DeltaVetal26/ElevatorModel-2.0/PCB/FloorBoard/FloorBoard_Brd.png

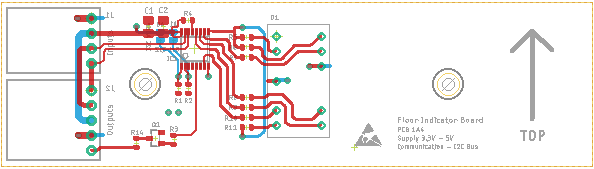
PCB/FloorBoard/FloorBoard_Brd.png
