DeltaVetal26/ElevatorModel-2.0/PCB/FloorBoard/FloorBoard_Sch.png

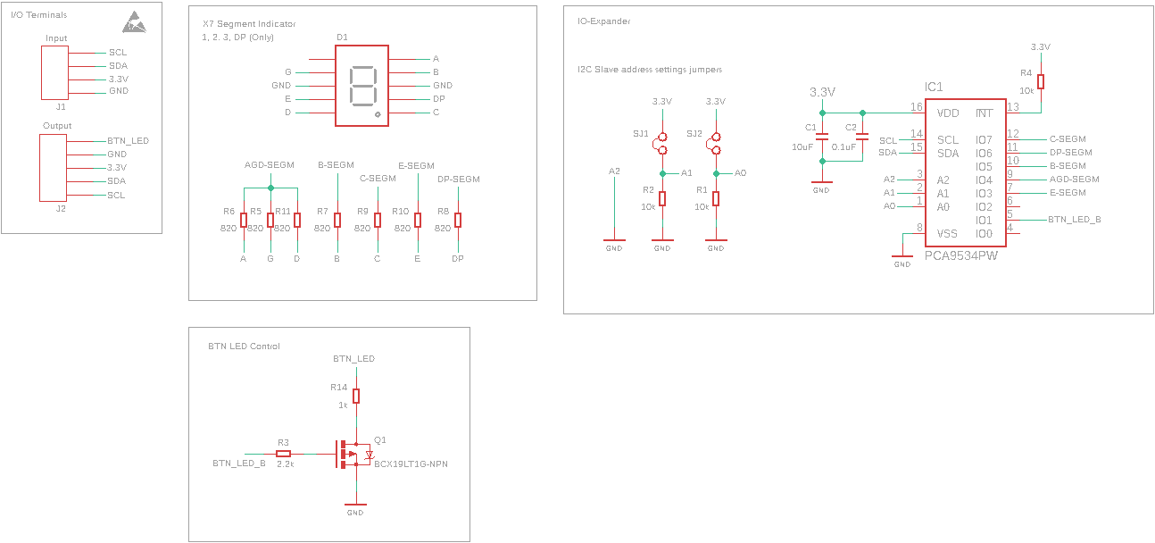
PCB/FloorBoard/FloorBoard_Sch.png
