DeltaVetal26/ElevatorModel-2.0/PCB/FloorBoard/FloorBoard_Vis.png

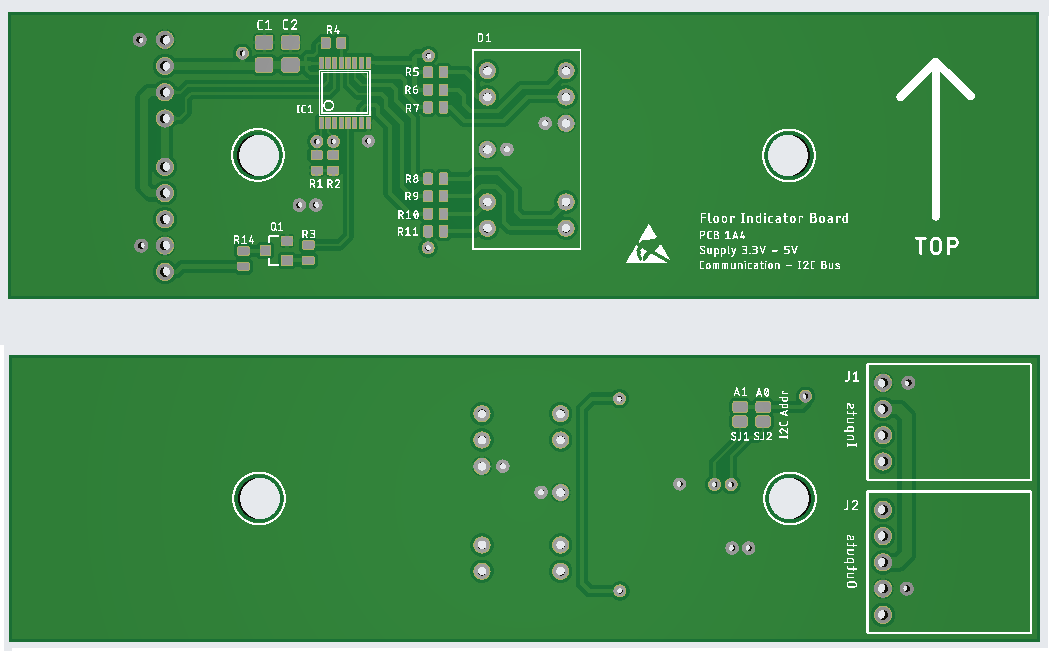
PCB/FloorBoard/FloorBoard_Vis.png
