DeltaVetal26/ElevatorModel-2.0/PCB/MainBoard/MainBoard_Brd.png

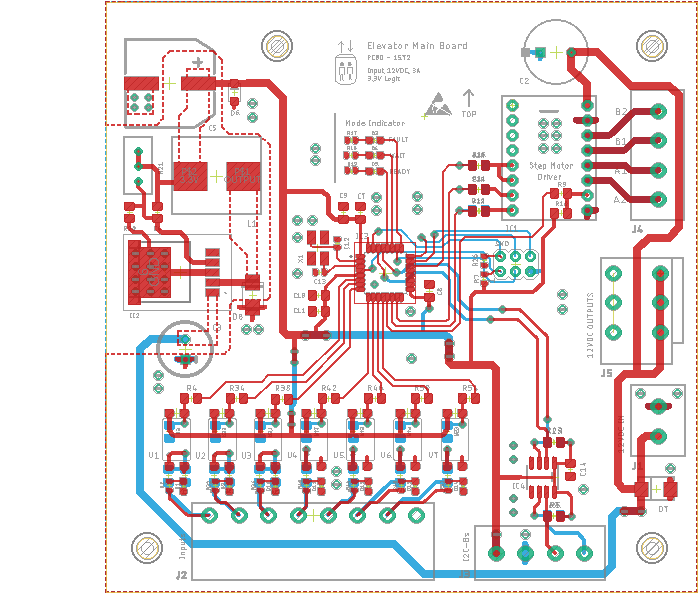
PCB/MainBoard/MainBoard_Brd.png
