DeltaVetal26/ElevatorModel-2.0/PCB/MainBoard/MainBoard_Sch.png

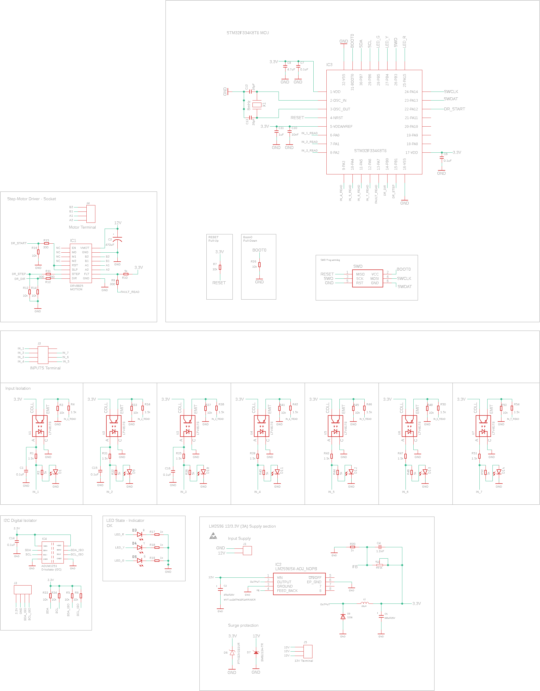
PCB/MainBoard/MainBoard_Sch.png
