DeltaVetal26/ElevatorModel-2.0/PCB/MainBoard/MainBoard_Vis.png

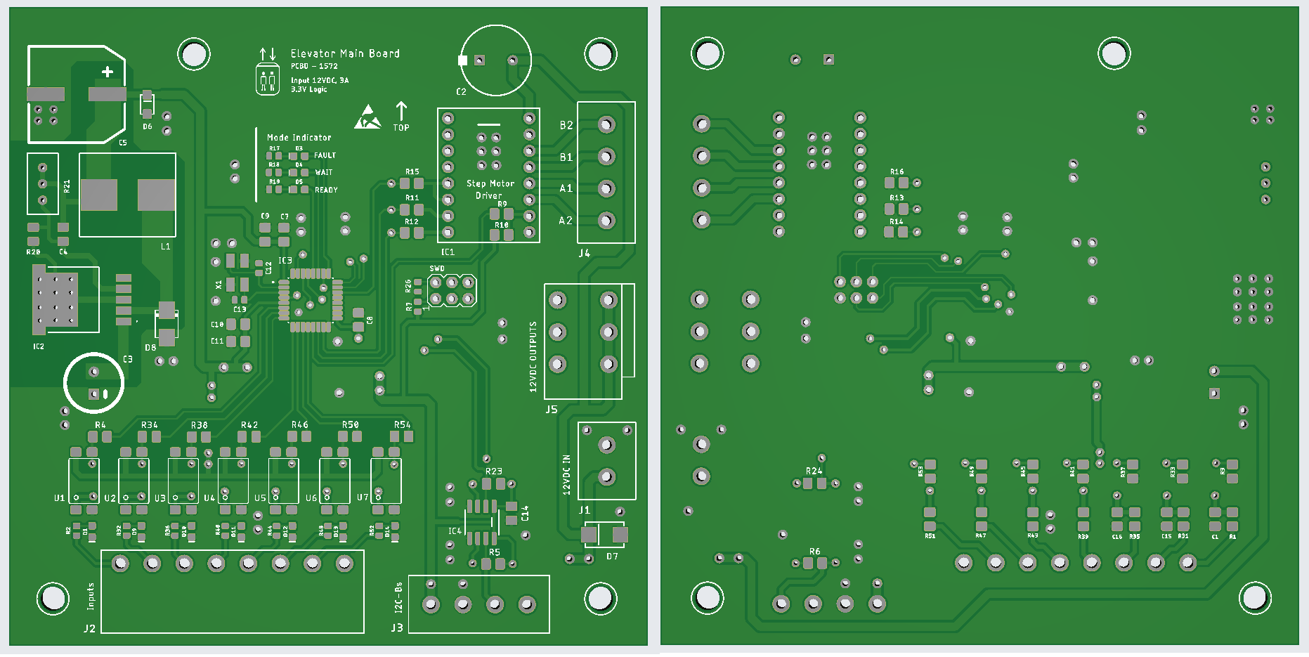
PCB/MainBoard/MainBoard_Vis.png
