DeltaVetal26/ElevatorModel-2.0/PCB/FloorBoard/Schematic.brd

## EAGLE design PCB/FloorBoard/Schematic.brd (2021-07-06)

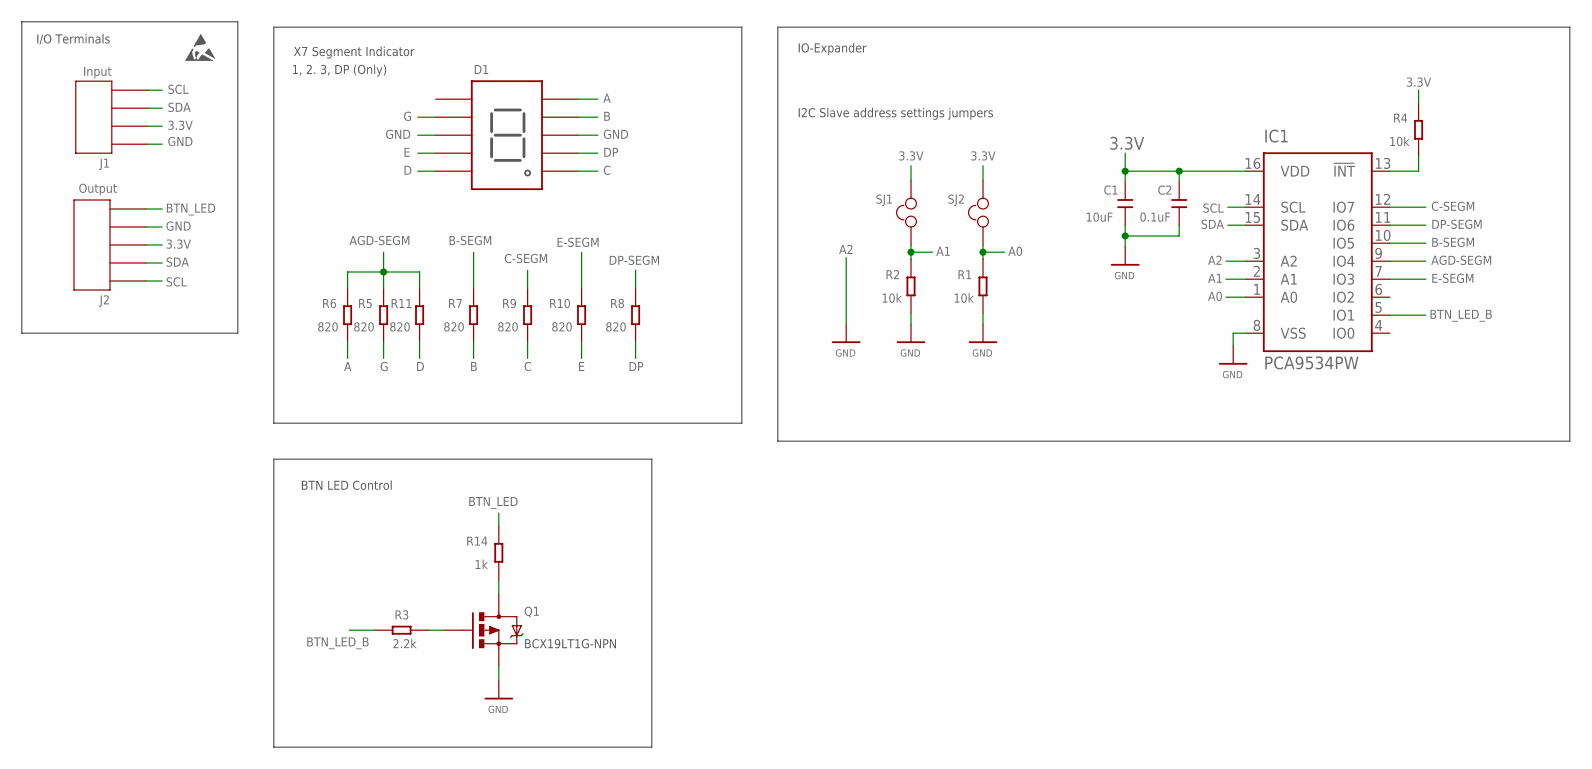
[picture p11: schematic Schematic.sch]

Parts:
C1: 10uF; SMD-CAP-0805
C2: 0.1uF; SMD-CAP-0805
D1: GNS-3011CS-21
IC1: PCA9534PW; TSSOP16
J1: Input; WF-4R
J2: Output; WF-5R
Q1: MOSFET-PCHANNEL; SOT23-3
R1, R2, R4: 10k; SMD-RES-0603
R3: 2.2k; SMD-RES-0603
R5, R6, R7, R8, R9, R10, R11: 820; SMD-RES-0603
R14: 1k; SMD-RES-0603
SJ1, SJ2: SOLDER-JUMPER
U$2: ESD-LOGO

Connections:
3.3V: C1.2, C2.2, IC1.16 (VDD), J1.P$2, J2.P$3, R4.2, SJ1.P$2, SJ2.P$2
A: D1.A, R6.1
A0: IC1.1 (A0), R1.2, SJ2.P$1
A1: IC1.2 (A1), R2.2, SJ1.P$1
A2: IC1.3 (A2)
AGD-SEGM: IC1.9 (IO4), R5.2, R6.2, R11.2
B: D1.B, R7.1
B-SEGM: IC1.10 (IO5), R7.2
BTN_LED: J2.P$5, R14.2
BTN_LED_B: IC1.5 (IO1), R3.2
C: D1.C, R9.1
C-SEGM: IC1.12 (IO7), R9.2
D: D1.D, R11.1
DP: D1.DP, R8.1
DP-SEGM: IC1.11 (IO6), R8.2
E: D1.E, R10.1
E-SEGM: IC1.7 (IO3), R10.2
G: D1.G, R5.1
GND: C1.1, C2.1, D1.CATHODE_1, D1.CATHODE_2, IC1.8 (VSS), J1.P$1, J2.P$4, Q1.2 (S), R1.1, R2.1
unnamed: IC1.13 (!INT), R4.1
unnamed: Q1.3 (D), R14.1
unnamed: Q1.1 (G), R3.1
SCL: IC1.14 (SCL), J1.P$4, J2.P$1
SDA: IC1.15 (SDA), J1.P$3, J2.P$2

Notes on the sheet:
I/O Terminals
X7 Segment Indicator
1, 2. 3, DP (Only)
IO-Expander
I2C Slave address settings jumpers
BCX19LT1G-NPN
BTN LED Control

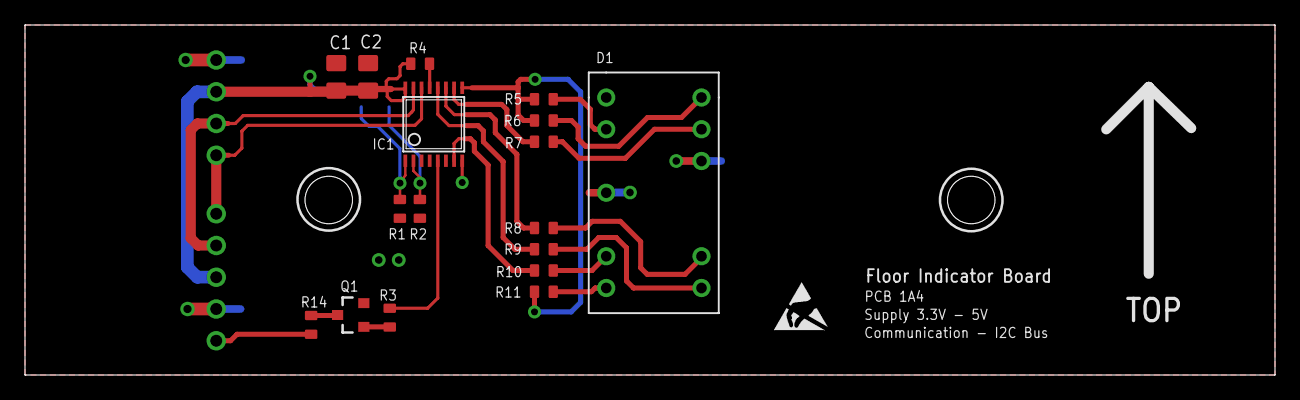
[picture p12: board PCB/FloorBoard/Schematic.brd from above]

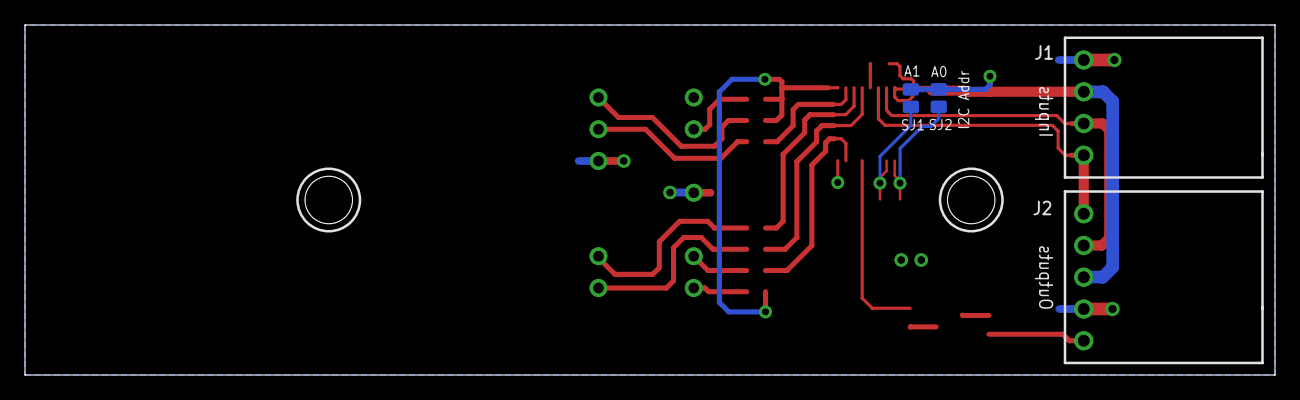
[picture p13: board PCB/FloorBoard/Schematic.brd from below]

Board: 2 copper layers, 100.0 x 28.0 mm, 22 parts (4 on the bottom side), 23 nets.
