DeltaVetal26/ElevatorModel-2.0/PCB/MainBoard/mainBoard.brd

## EAGLE design PCB/MainBoard/mainBoard.brd (2021-07-06)

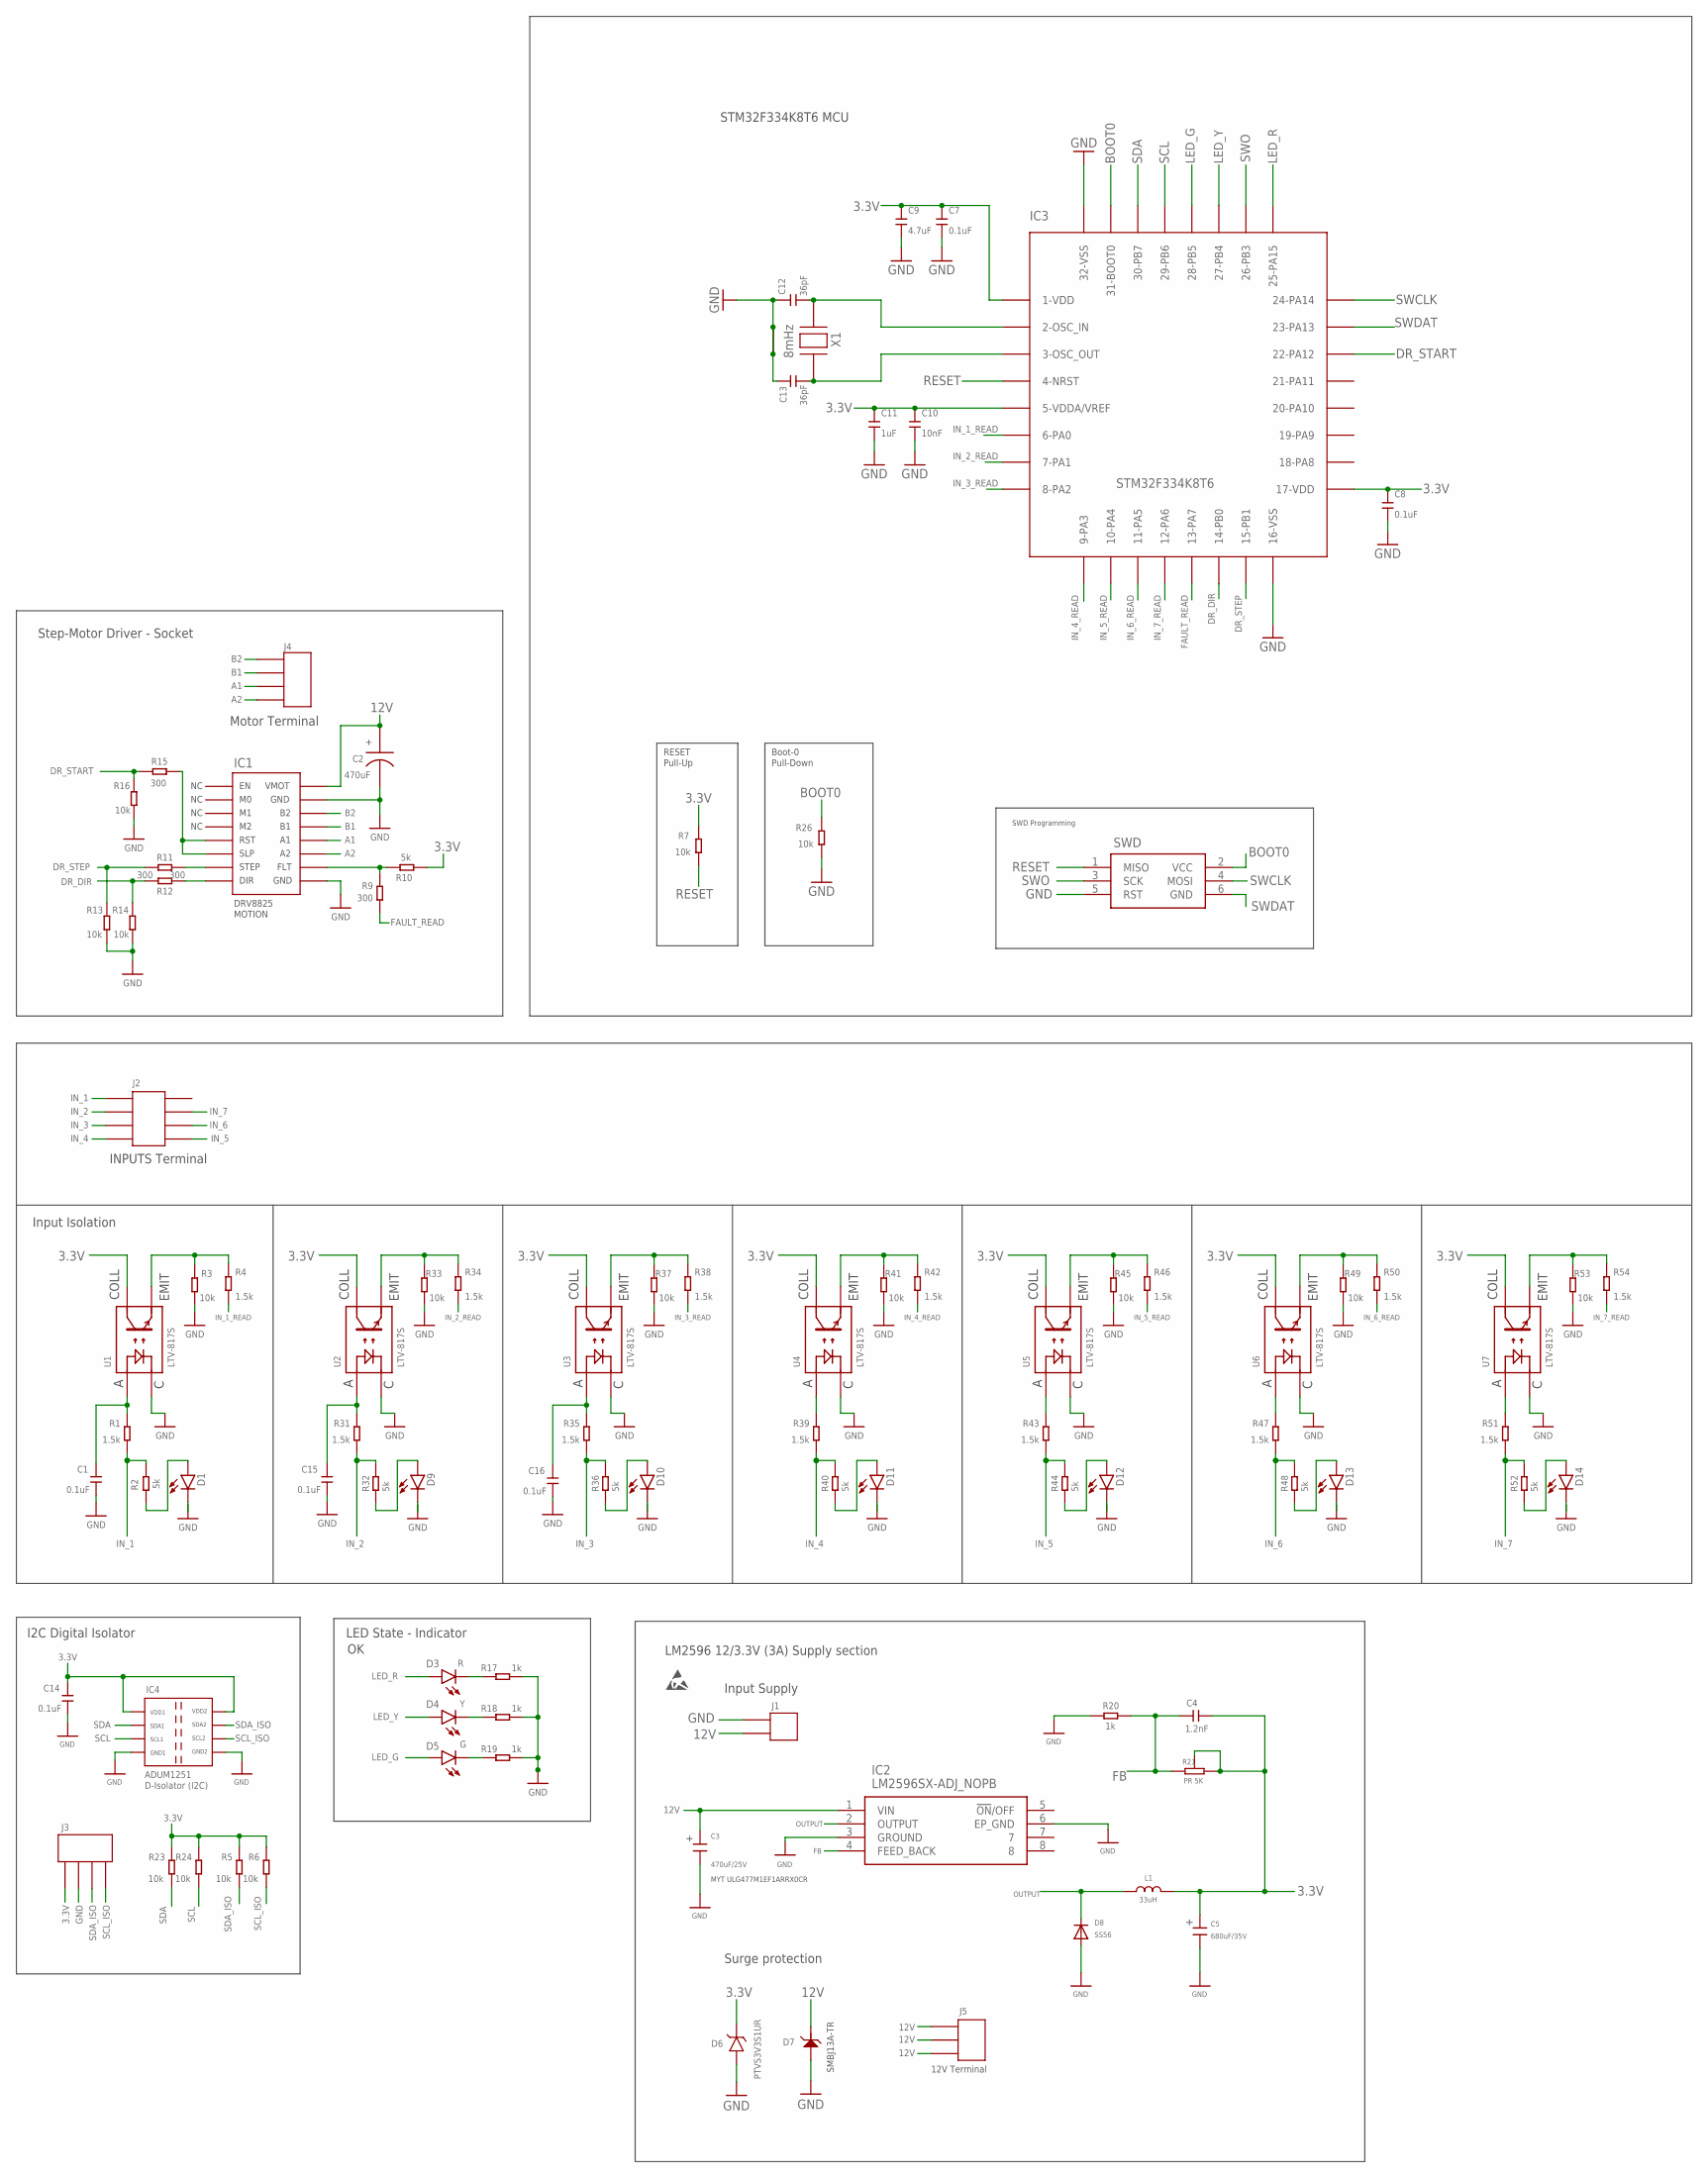
[picture p14: schematic mainBoard.sch]

Parts:
C1, C7, C8, C14, C15, C16: 0.1uF; SMD-CAP-0805
C2: 470uF; EPCOS-CAP-10X16
C3: MYT-680UF-25V-D8MM-F16
C4: 1.2nF; SMD-CAP-0805
C5: PANASONIC-SMT-CAP-680UF
C9: 4.7uF; SMD-CAP-0805
C10: 10nF; SMD-CAP-0805
C11: 1uF; SMD-CAP-0805
C12, C13: 36pF; SMD-CAP-0603
D1, D9, D10, D11, D12, D13, D14: LED0603; LED-0603
D3: R; LED-0603
D4: Y; LED-0603
D5: G; LED-0603
D6: PTVS3V3S1UR
D7: TVS-SMBJ13A-LFUSE
D8: S2A; DO214AA
IC1: DRV8825-DRIVER
IC2: LM2596SX-ADJ_NOPB; LM2596SXADJNOPB
IC3: STM32F334K8T6; QFP80P900X900X160-32N
IC4: ADUM1251ARZ-RL7
J1: DG127-5.0-2P
J2: 5EHDR-08P-5.00
J3, J4: DG127-5.0-4P
J5: PRESS-TERMINAL-5.0-3P
L1: SUNLTECHTEC-HSLO1365H330MTT
R1, R4, R31, R34, R35, R38, R39, R42, R43, R46, R47, R50, R51, R54: 1.5k; R0805
R2, R32, R36, R40, R44, R48, R52: 5k; SMD-RES-0603
R3, R5, R6, R13, R14, R16, R23, R24, R33, R37, R41, R45, R49, R53: 10k; R0805
R7, R26: 10k; SMD-RES-0603
R9, R11, R12, R15: 300; R0805
R10: 5k; R0805
R17, R18, R19: 1k; SMD-RES-0603
R20: 1k; R0805
R21: BOURNS-3296W-PREC-RESISTOR-5K
SWD: AVRISP-6; AVRISP
U1, U2, U3, U4, U5, U6, U7: LTV-817S
U$1: ESD-LOGO
X1: 8mHz; CRYSTALL-YTC-X50328MSB4SI

Connections:
3.3V: C4.2, C5.+, C7.2, C8.2, C9.2, C10.2, C11.2, C14.2, D6.C, IC3.1-VDD, IC3.5-VDDA/VREF, IC3.17-VDD, IC4.VDD1, IC4.VDD2, J3.P$1, L1.P$2, R5.2, R6.2, R7.2, R10.2, R21.CW-3, R21.WIPER-2, R23.2, R24.2, U1.COLL (COLLECTOR), U2.COLL (COLLECTOR), U3.COLL (COLLECTOR), U4.COLL (COLLECTOR), U5.COLL (COLLECTOR), U6.COLL (COLLECTOR), U7.COLL (COLLECTOR)
12V: C2.+, C3.+, D7.-, IC1.VMOT, IC2.1 (VIN), J1.P$2, J5.A1, J5.A2, J5.A3, J5.B1, J5.B2, J5.B3
A1: IC1.A1, J4.P$3
A2: IC1.A2, J4.P$4
B1: IC1.B1, J4.P$2
B2: IC1.B2, J4.P$1
BOOT0: IC3.31-BOOT0, R26.2, SWD.2 (VCC)
DR_DIR: IC3.14-PB0, R12.1, R14.2
DR_START: IC3.22-PA12, R15.1, R16.2
DR_STEP: IC3.15-PB1, R11.1, R13.2
FAULT_READ: IC3.13-PA7, R9.2
FB: C4.1, IC2.4 (FEED_BACK), R20.2, R21.CCW-1
GND: C1.1, C2.-, C3.-, C5.-, C7.1, C8.1, C9.1, C10.1, C11.1, C12.1, C13.1, C14.1, C15.1, C16.1, D1.C, D6.A, D7.+, D8.A, D9.C, D10.C, D11.C, D12.C, D13.C, D14.C, IC1.GND, IC1.GND_1, IC2.3 (GROUND), IC2.6 (EP_GND), IC3.16-VSS, IC3.32-VSS, IC4.GND1, IC4.GND2, J1.P$1, J3.P$2, R3.2, R13.1, R14.1, R16.1, R17.1, R18.1, R19.1, R20.1, R26.1, R33.2, R37.2, R41.2, R45.2, R49.2, R53.2, SWD.5 (RST), U1.C, U2.C, U3.C, U4.C, U5.C, U6.C, U7.C, X1.2 (G1), X1.4 (G2)
IN_1: J2.1, R1.1, R2.2
IN_1_READ: IC3.6-PA0, R4.2
IN_2: J2.2, R31.1, R32.2
IN_2_READ: IC3.7-PA1, R34.2
IN_3: J2.3, R35.1, R36.2
IN_3_READ: IC3.8-PA2, R38.2
IN_4: J2.4, R39.1, R40.2
IN_4_READ: IC3.9-PA3, R42.2
IN_5: J2.5, R43.1, R44.2
IN_5_READ: IC3.10-PA4, R46.2
IN_6: J2.6, R47.1, R48.2
IN_6_READ: IC3.11-PA5, R50.2
IN_7: J2.7, R51.1, R52.2
IN_7_READ: IC3.12-PA6, R54.2
LED_G: D5.A, IC3.28-PB5
LED_R: D3.A, IC3.25-PA15
LED_Y: D4.A, IC3.27-PB4
unnamed: D1.A, R2.1
unnamed: R3.1, R4.1, U1.EMIT (EMITTER)
unnamed: IC1.STEP, R11.2
unnamed: IC1.FAULT, R9.1, R10.1
unnamed: IC1.DIR, R12.2
unnamed: D3.C, R17.2
unnamed: IC1.RST, IC1.SLEEP, R15.2
unnamed: D4.C, R18.2
unnamed: D5.C, R19.2
unnamed: C12.2, IC3.2-OSC_IN, X1.3
unnamed: C13.2, IC3.3-OSC_OUT, X1.1
unnamed: C15.2, R31.2, U2.A
unnamed: D9.A, R32.1
unnamed: R33.1, R34.1, U2.EMIT (EMITTER)
unnamed: C16.2, R35.2, U3.A
unnamed: D10.A, R36.1
unnamed: R37.1, R38.1, U3.EMIT (EMITTER)
unnamed: R39.2, U4.A
unnamed: D11.A, R40.1
unnamed: R41.1, R42.1, U4.EMIT (EMITTER)
unnamed: R43.2, U5.A
unnamed: D12.A, R44.1
unnamed: R45.1, R46.1, U5.EMIT (EMITTER)
unnamed: R47.2, U6.A
unnamed: D13.A, R48.1
unnamed: R49.1, R50.1, U6.EMIT (EMITTER)
unnamed: R51.2, U7.A
unnamed: D14.A, R52.1
unnamed: R53.1, R54.1, U7.EMIT (EMITTER)
unnamed: C1.2, R1.2, U1.A
OUTPUT: D8.C, IC2.2 (OUTPUT), L1.P$1
RESET: IC3.4-NRST, R7.1, SWD.1 (MISO)
SCL: IC3.29-PB6, IC4.SCL1, R24.1
SCL_ISO: IC4.SCL2, J3.P$4, R6.1
SDA: IC3.30-PB7, IC4.SDA1, R23.1
SDA_ISO: IC4.SDA2, J3.P$3, R5.1
SWCLK: IC3.24-PA14, SWD.4 (MOSI)
SWDAT: IC3.23-PA13, SWD.6 (GND)
SWO: IC3.26-PB3, SWD.3 (SCK)

Notes on the sheet:
Input Isolation
Step-Motor Driver - Socket
LED State - Indicator
Surge protection
SMBJ13A-TR
470uF/25V
SS56
33uH
680uF/35V
PR 5K
MYT ULG477M1EF1ARRX0CR
LM2596 12/3.3V (3A) Supply section
STM32F334K8T6 MCU
RESET
Pull-Up
Boot-0
Pull-Down
SWD Programming
I2C Digital Isolator
Input Supply
INPUTS Terminal
Motor Terminal
12V Terminal

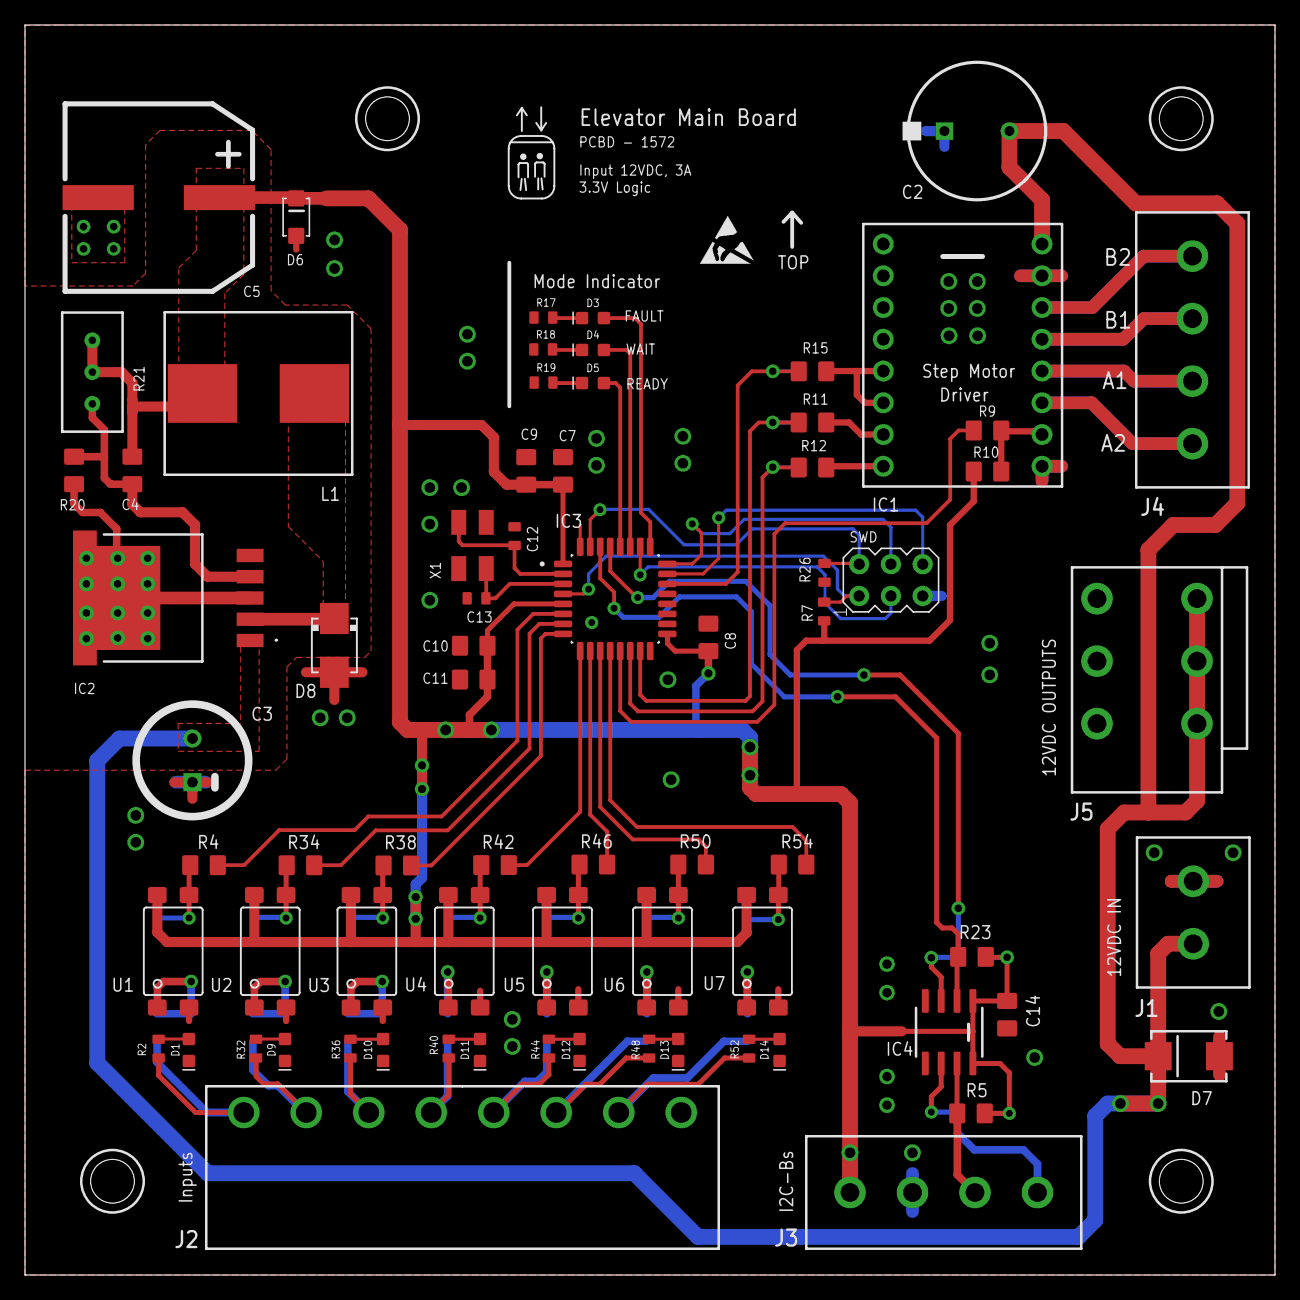
[picture p15: board mainBoard.brd from above]

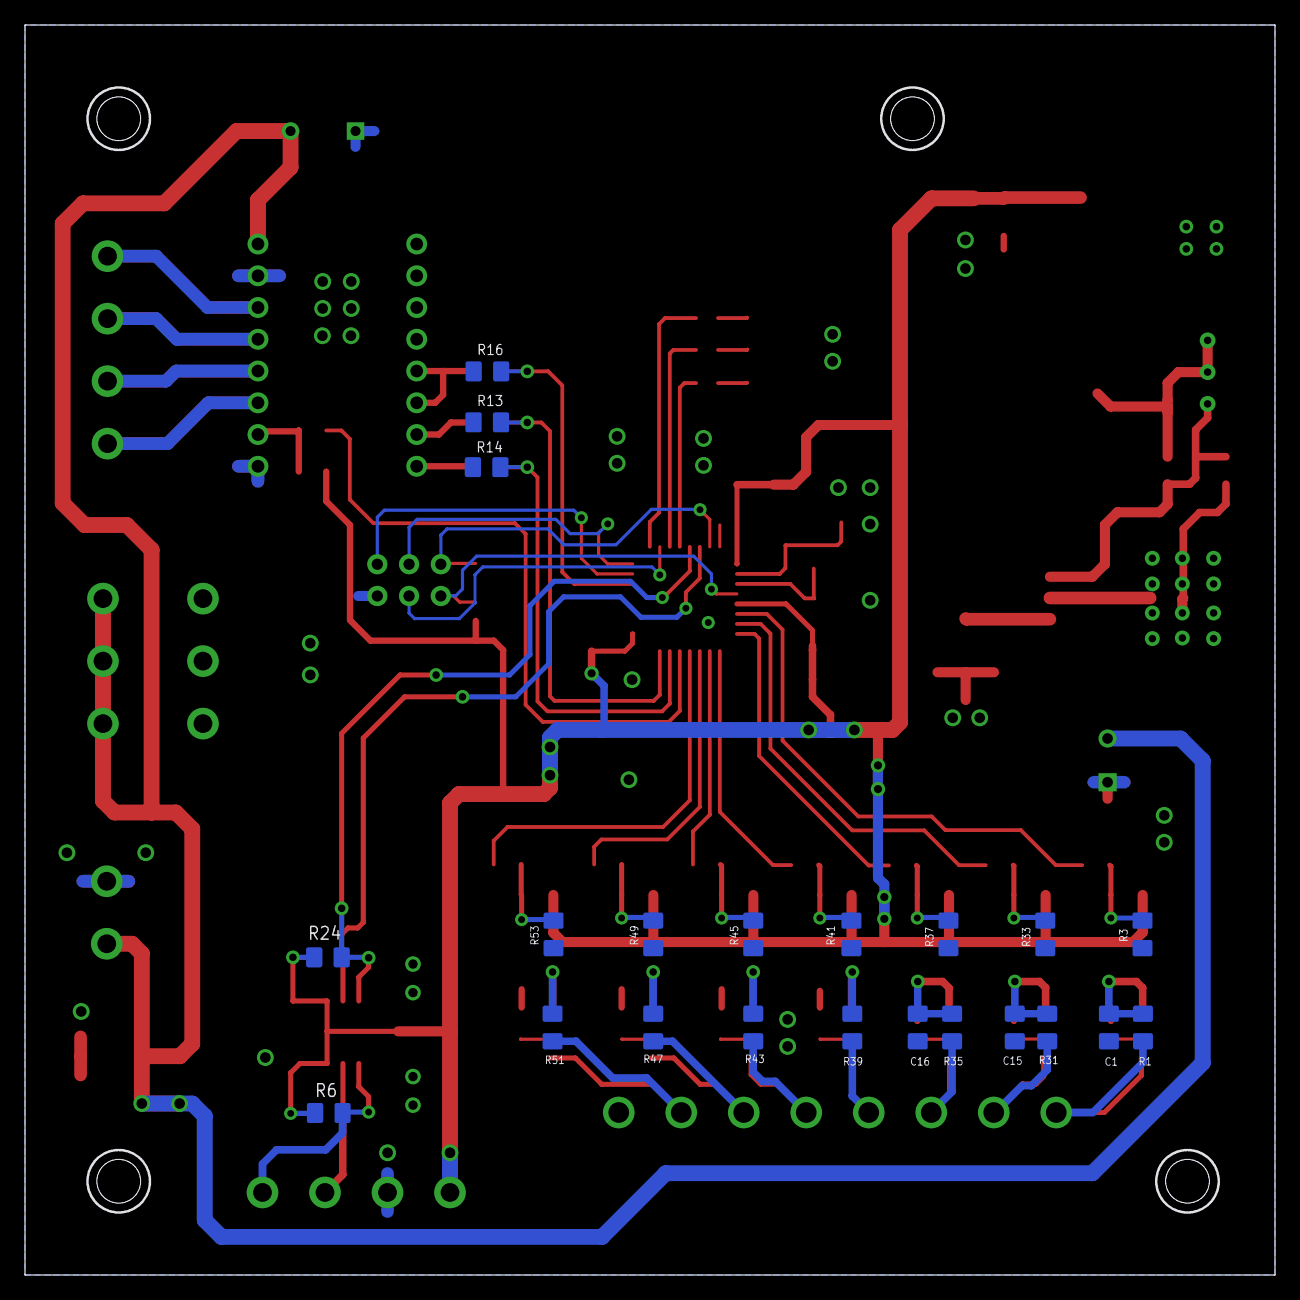
[picture p16: board mainBoard.brd from below]

Board: 2 copper layers, 100.0 x 100.0 mm, 95 parts (22 on the bottom side), 69 nets.
