DeltaVetal26/ElevatorModel-2.0/PCB/FloorSensor/Schematic.brd

## EAGLE design PCB/FloorSensor/Schematic.brd (2021-07-06)

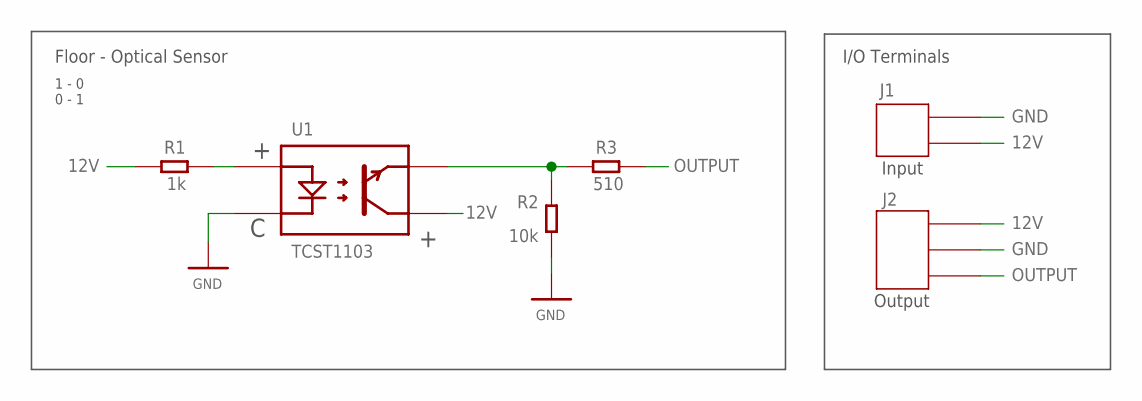
[picture p17: schematic Schematic.sch]

Parts:
J1: WF-2R
J2: WF-3R
R1: 1k; SMD-RES-0603
R2: 10k; SMD-RES-0603
R3: 510; SMD-RES-0603
U1: TCST1103

Connections:
12V: J1.P$1, J2.P$3, R1.2, U1.OUTPUT_VCC
GND: J1.P$2, J2.P$2, R2.2, U1.INPUT_C (C)
unnamed: R1.1, U1.INPUT_VCC
unnamed: R2.1, R3.2, U1.OUTPUT
OUTPUT: J2.P$1, R3.1

Notes on the sheet:
Floor - Optical Sensor
1 - 0
0 - 1
Input
Output
I/O Terminals

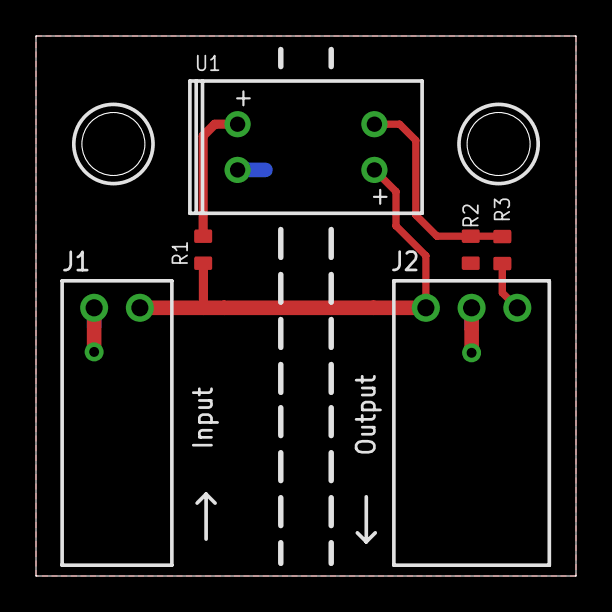
[picture p18: board PCB/FloorSensor/Schematic.brd from above]

Board: 2 copper layers, 30.0 x 30.0 mm, 6 parts (0 on the bottom side), 5 nets.
