DeltaVetal26/ElevatorModel-2.0/MainBoardFirmware.ioc

Mcu.UserName=STM32F334K8Tx
PB6.Signal=I2C1_SCL
PB7.Signal=I2C1_SDA
