DeltaVetal26/ElevatorModel-2.0/(notices)

Notices in the files:
parts and their libraries:
User-Submitted: Licensing: Creative Commons ShareAlike 4.0 International - https://creativecommons.org/licenses/by-sa/4.0
